FBTUG/topower_v1/arduino/RosArduinoHelloWorld/RosArduinoHelloWorld.ino

#include <ros.h>
#include <std_msgs/String.h>
#include <std_msgs/Empty.h>

ros::NodeHandle  nh;

std_msgs::String str_msg;
ros::Publisher chatter("chatter", &str_msg);


void messageCb( const std_msgs::Empty& toggle_msg){
  digitalWrite(13, HIGH-digitalRead(13));   // blink the led
  str_msg.data = "recieve toggle message";
  chatter.publish( &str_msg );
}
ros::Subscriber<std_msgs::Empty> sub("toggle_led", &messageCb );


void setup()
{
  pinMode(13, OUTPUT);
  nh.initNode();
  nh.advertise(chatter);
  nh.subscribe(sub);
}

void loop()
{
  nh.spinOnce();
  delay(1);
}
