FBTUG/topower_v1/(commit log)

2019-07-02 add arduino wheel/pan tilt servo control
2019-07-04 add pan tilt control. change to software pwm
2019-07-06 add robot model & rviz launch
    [materials.xacro, topower_v1.xacro, topower_v1_common.xacro, topower_v1_pan_tilt_cam.urdf.xacro, topower_v1_vehicle.urdf.xacro]
2019-07-06 add arm xacro
    [topower_v1.xacro, topower_v1_arm.urdf.xacro, topower_v1_common.xacro]
2019-07-07 add gazebo launch file
    [materials.xacro, topower_v1.xacro, topower_v1_arm.urdf.xacro, topower_v1_common.xacro, topower_v1_pan_tilt_cam.urdf.xacro, topower_v1_vehicle.urdf.xacro]
2019-07-08 change wheel controller to effort controller
2019-07-08 adjust pid parameter
    [topower_v1_arm.urdf.xacro]
2019-07-22 add moveit package. esp8266 arm control. robot hardware interface
    [fake_controllers.yaml, joint_limits.yaml, materials.xacro, ros_controllers.yaml, topower_v1.xacro, topower_v1_arm.urdf.xacro, topower_v1_common.xacro, topower_v1_pan_tilt_cam.urdf.xacro]
2019-07-24 add moveit control to arm hardware
    [topower_v1_arm.urdf.xacro]
2019-07-28 control arm directly from action client for faster response when moving using joystick
    [topower_v1_pan_tilt_cam.urdf.xacro]
2019-07-28 remove rviz in topower_v1_demo.launch. change camera image topic.
2019-07-29 add camera image save function
2019-07-29 add position joint limit to hardware interface. increate default camera capture resolution. drop wait for result in joystick arm control
2019-07-29 add camera image flip function
    [RosESP8266Arm.ino]
2019-08-02 add yolo detection function
    [yolov3-tiny.cfg]
2019-08-04 update yolo node & training weight
    [yolov3-tiny.cfg]
2019-08-05 add apriltag function. allow camera image vertical & horizontal flipping
2019-08-06 update joint limit. update arm move speed
    [joint_limits.yaml]
2019-08-09 add photo folder. update gripper open/close control
2019-08-09 update arm gripper control
    [ros_controllers.yaml]
2019-08-09 fix bug: arm joy control not work after reseting to standby pose
